Detholomew/CarabineLaser/README.md

# CarabineLaser
Projet d'une carabine laser avec une cible pour biathlon.
