Detholomew/CarabineLaser/KICAD/cible.kicad_pcb

## KiCad design KICAD/cible.kicad_pcb (2017-03-31)

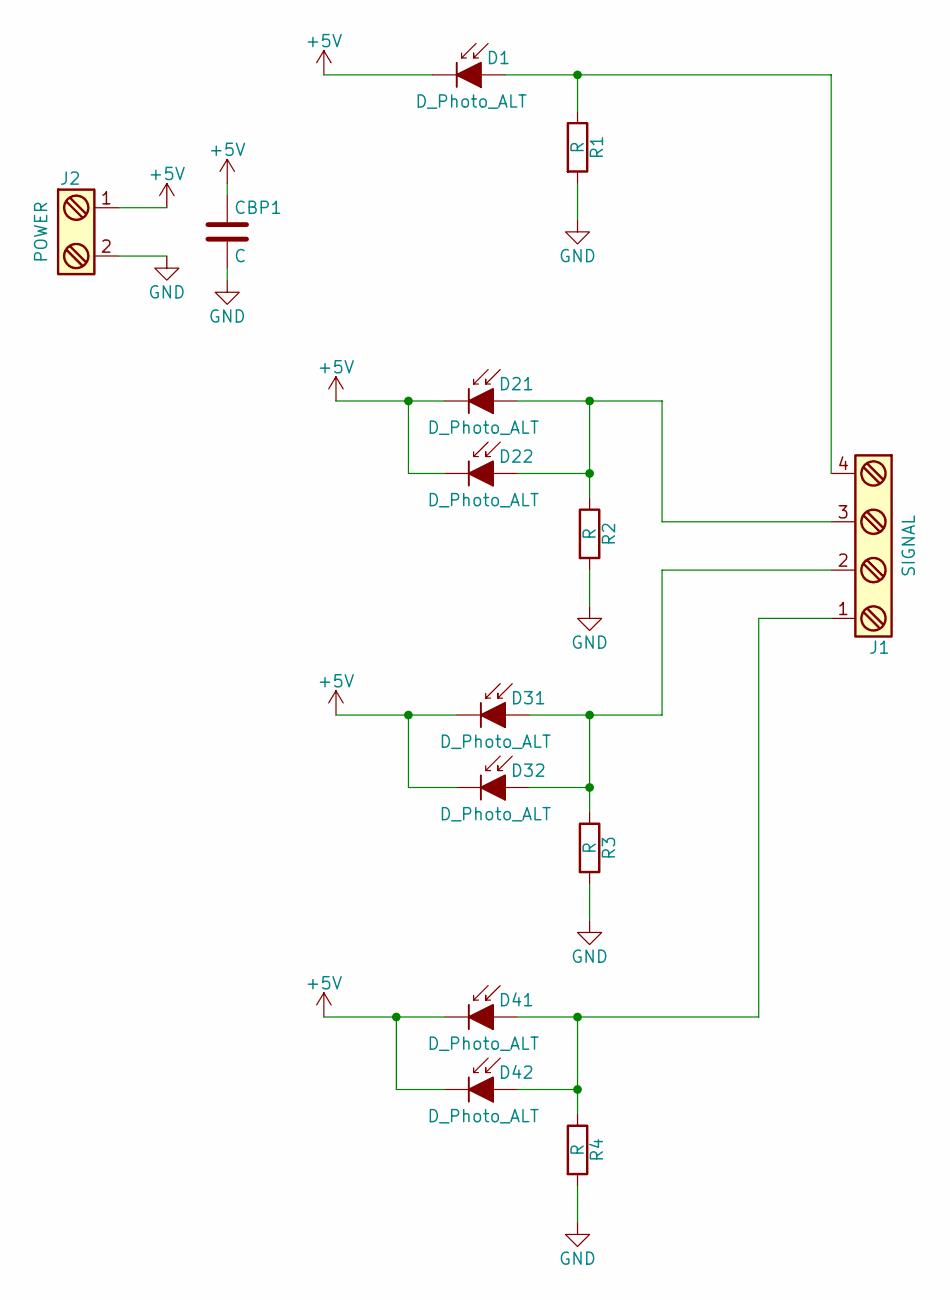
[picture p3: schematic cible.sch]

Parts:
CBP1: C; C_0805_HandSoldering
D1, D21, D22, D31, D32, D41, D42: D_Photo_ALT; LED_D5.0mm
J1: SIGNAL; Pin_Header_Straight_1x04_Pitch2.54mm
J2: POWER; Pin_Header_Straight_1x02_Pitch2.54mm
R1, R2, R3, R4: R; R_0805_HandSoldering

Connections:
+5V: CBP1.1, D1.1 (K), D21.1 (K), D22.1 (K), D31.1 (K), D32.1 (K), D41.1 (K), D42.1 (K), J2.1
GND: CBP1.2, J2.2, R1.2, R2.2, R3.2, R4.2
unnamed: D1.2 (A), J1.4, R1.1
unnamed: D21.2 (A), D22.2 (A), J1.3, R2.1
unnamed: D31.2 (A), D32.2 (A), J1.2, R3.1
unnamed: D41.2 (A), D42.2 (A), J1.1, R4.1

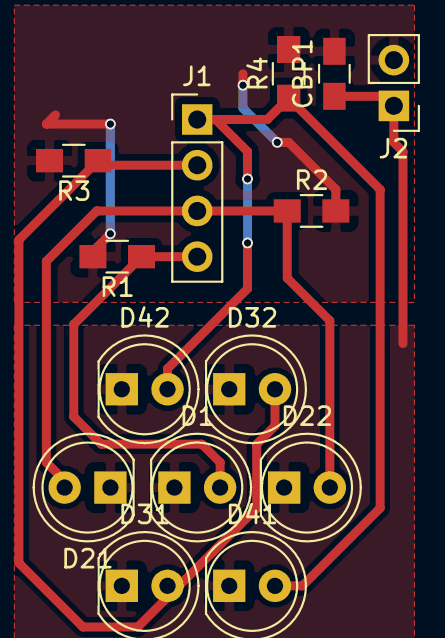
[picture p4: board cible.kicad_pcb from above]

Board: 2 copper layers, 14 parts (0 on the bottom side), 6 nets.
