Detholomew/CarabineLaser/(commit log)

2017-03-31 cible: arduino et design carte imprime
    programme de la cible et fichiers de la PCB de la cible
    [cible.kicad_pcb, cible.sch, donnees_soleil.ods]
2017-04-27 Version finale (ou presque de la carabine)
    Implémentation des affichages sur le LCD etc.. Manque uniquement le XBee
2017-04-27 Derniers changes a la cible et ajoute du rapport
